Balestrino/Micro-transponder/rc4_back.jpg

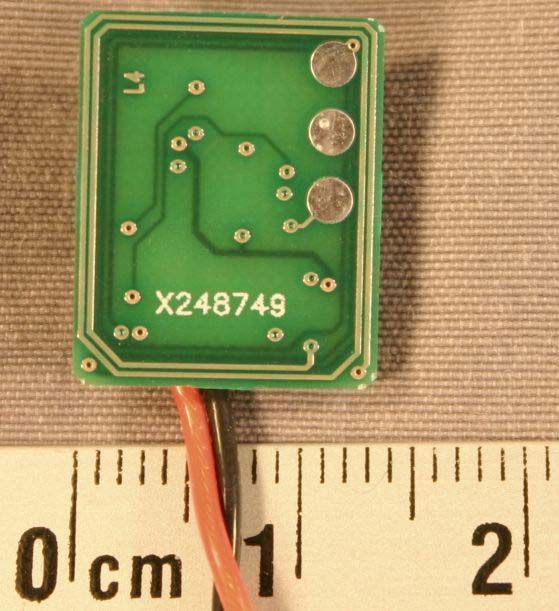
rc4_back.jpg
