Balestrino/Micro-transponder/rc4_front.jpg

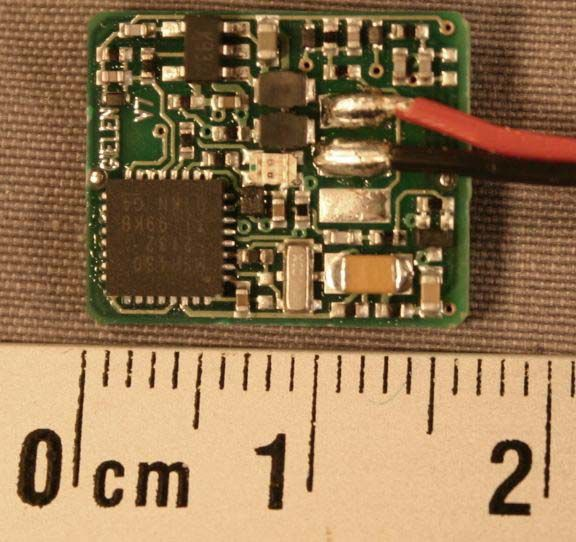
rc4_front.jpg
