Balestrino/Micro-transponder/2018_05_05/IMG_9358.JPG

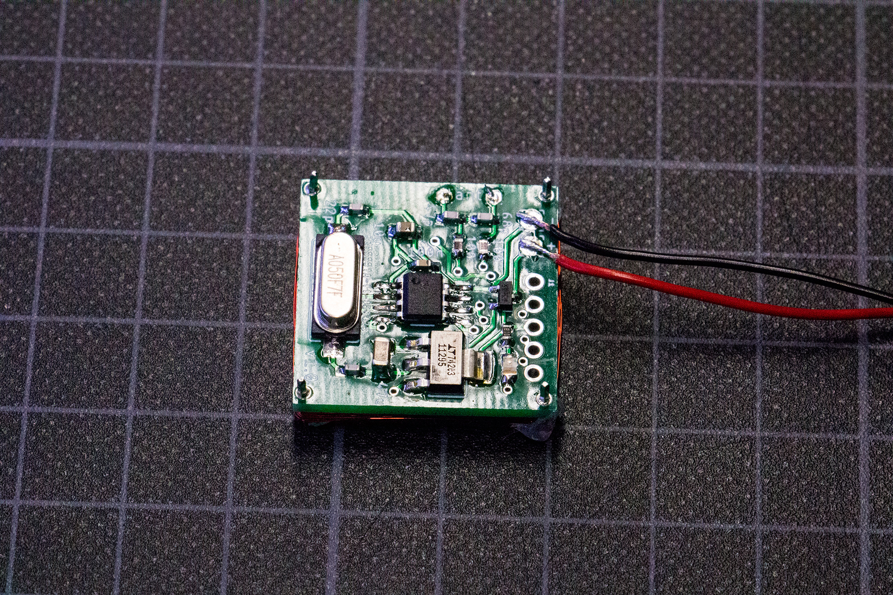
2018_05_05/IMG_9358.JPG
