Balestrino/Micro-transponder/2018_05_05/IMG_9359.JPG

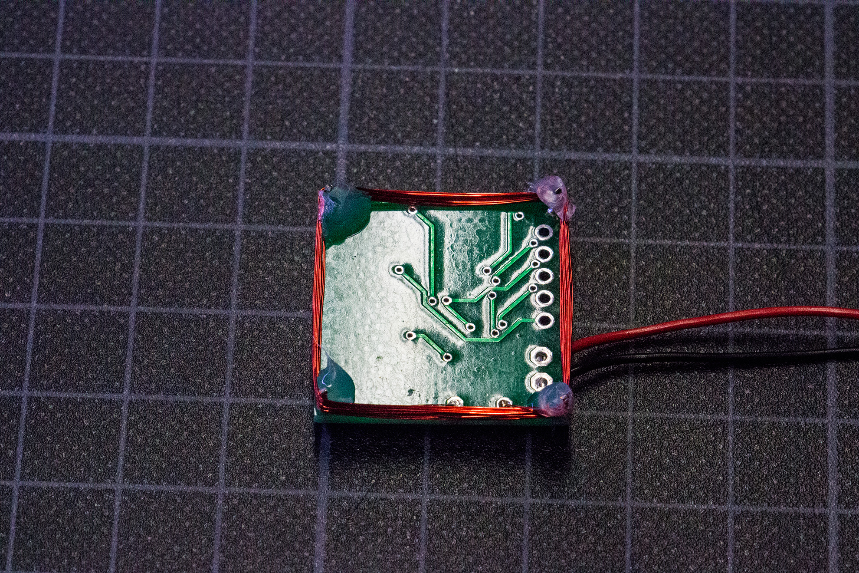
2018_05_05/IMG_9359.JPG
