Balestrino/Micro-transponder/loop antenna calculator.png

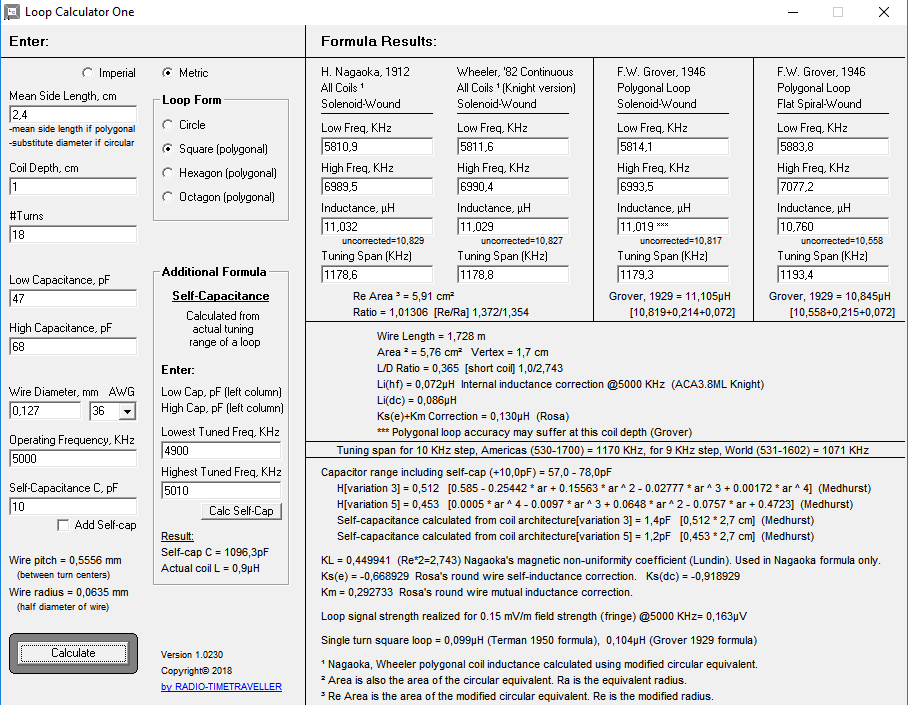
loop antenna calculator.png
