Balestrino/Micro-transponder/ssys_micro-transponder/micro-transponder.bmp

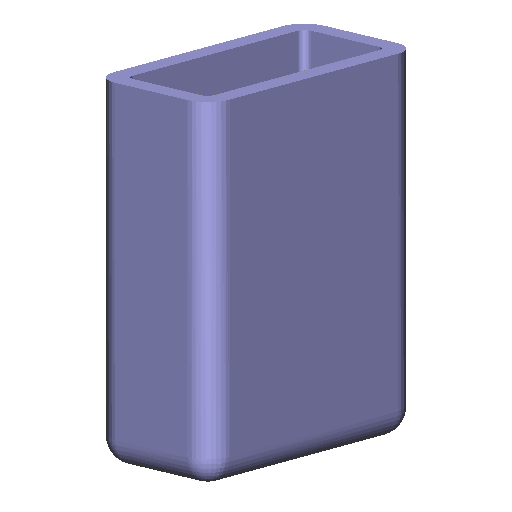
ssys_micro-transponder/micro-transponder.bmp
