Balestrino/Micro-transponder/CASE/Transpoder-case.SLDASM

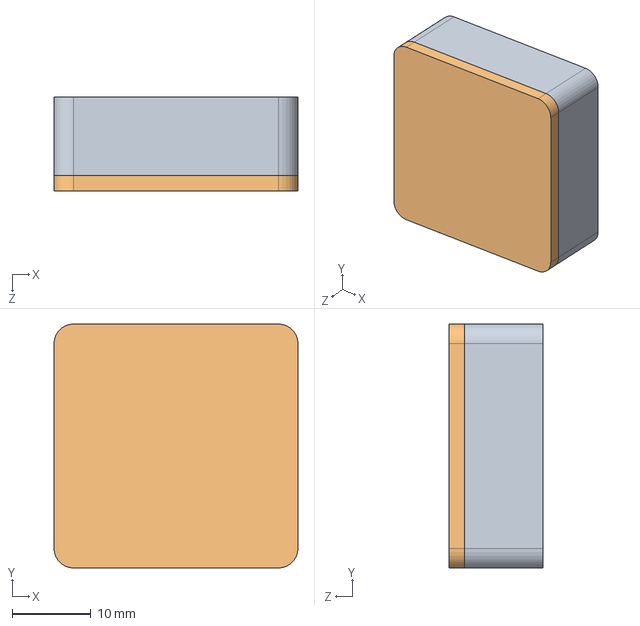
[picture p7: CAD file, 2021-03-31]
CASE/Transpoder-case.SLDASM
31.0 x 31.0 x 12.0 mm
Transponder-Case
Transponder-top
