Balestrino/Micro-transponder/CASE/Transponder-top.SLDPRT

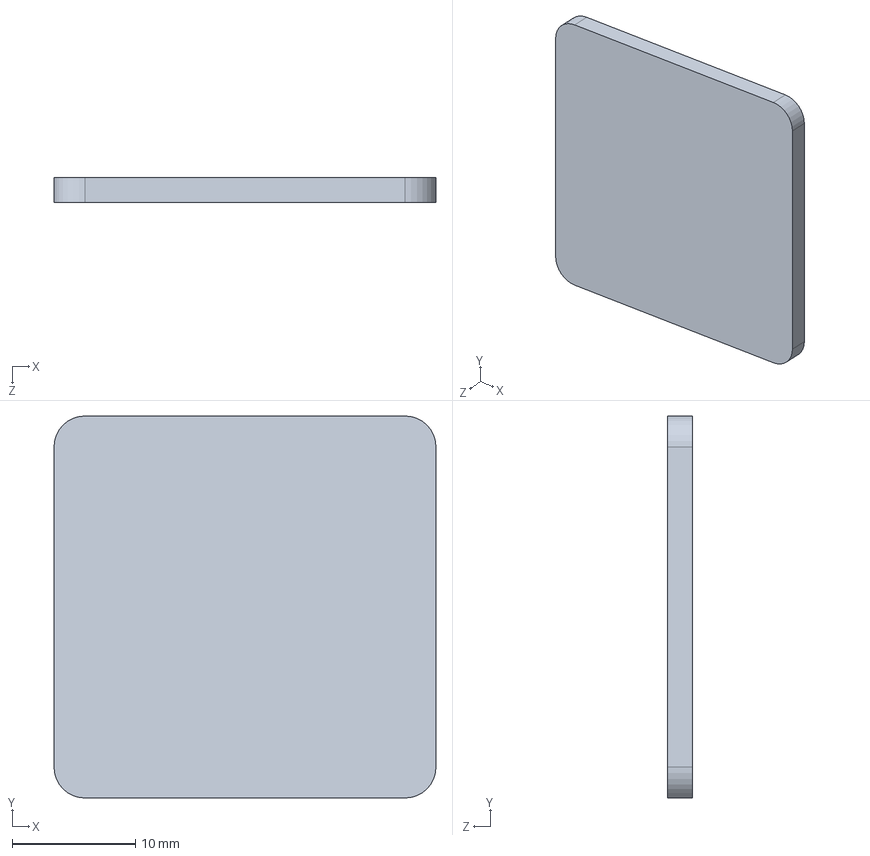
[picture p8: CAD file, 2021-03-31]
CASE/Transponder-top.SLDPRT
31.0 x 31.0 x 2.00 mm
