Balestrino/Micro-transponder/micro-transponder.SLDPRT

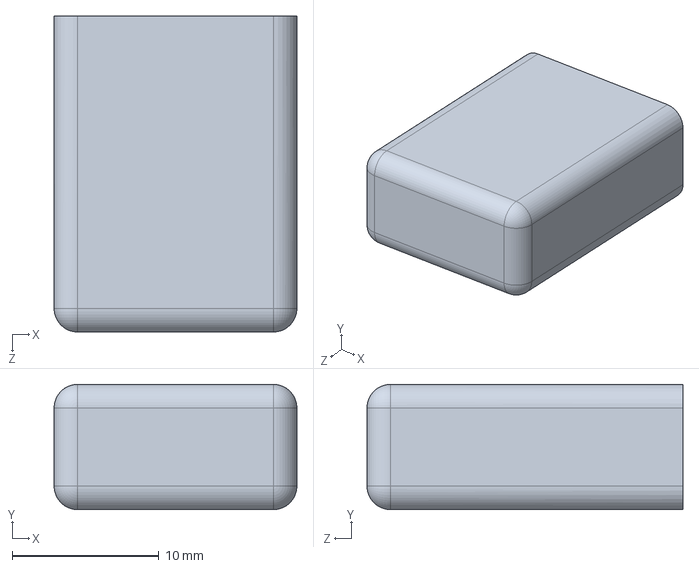
[picture p9: CAD file, 2021-03-31]
micro-transponder.SLDPRT
16.5 x 8.52 x 21.5 mm
