Balestrino/Micro-transponder/CASE/antenna_holder.SLDPRT

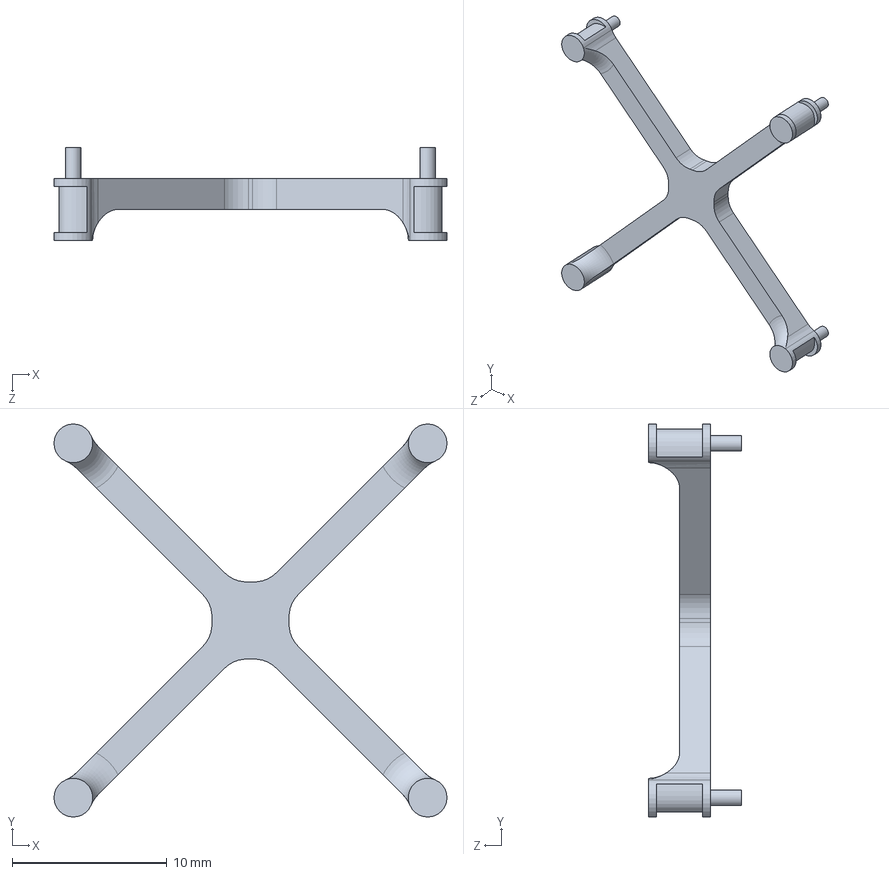
[picture p10: CAD file, 2021-03-31]
CASE/antenna_holder.SLDPRT
25.4 x 25.4 x 6.00 mm
