Balestrino/Micro-transponder/CASE/Transponder-Case.SLDPRT

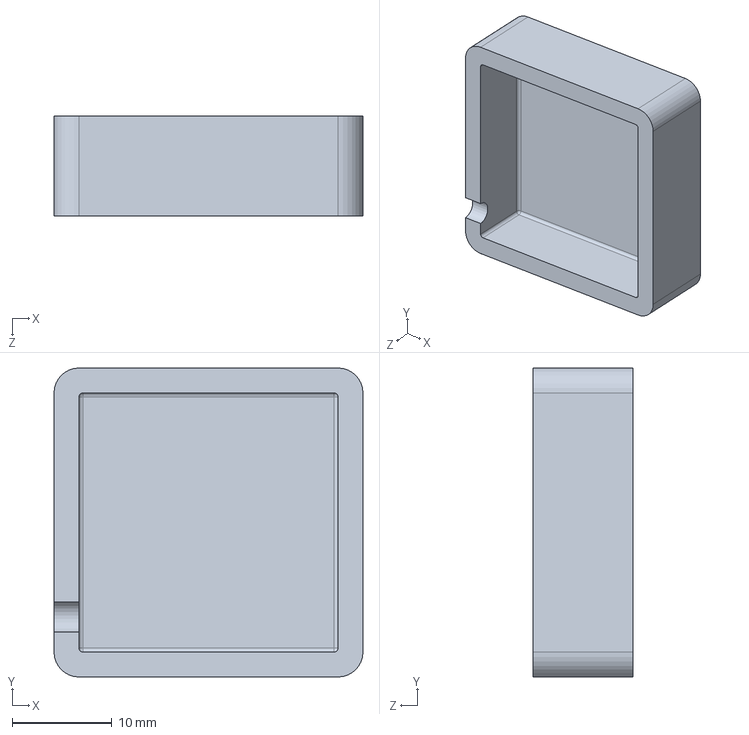
[picture p11: CAD file, 2021-03-31]
CASE/Transponder-Case.SLDPRT
31.0 x 31.0 x 10.0 mm
