Balestrino/Micro-transponder/(list of files, cad)

Other CAD files:
CASE/Transponder-Case.STL
CASE/Transponder-top.STL
CASE/antenna_holder.STL
micro-transponder.STL
