Balestrino/Micro-transponder/schematics.pdf

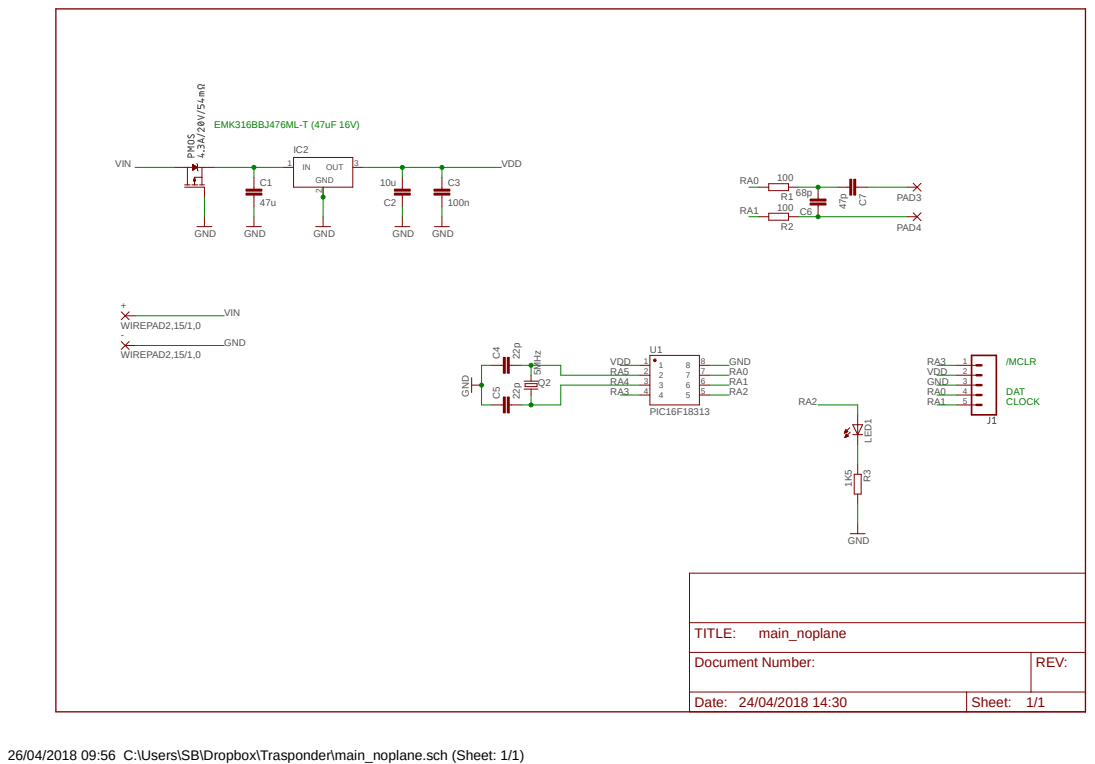
[picture p12: page 1]

Document Number: | REV:

Date: 24/04/2018 14:30 | Sheet: 1/1

26/04/2018 09:56 C:\Users\SB\Dropbox\Trasponder\main_noplane.sch (Sheet: 1/1)
