Balestrino/Micro-transponder/Electronic board/micro_transponder.brd

## EAGLE design Electronic board/micro_transponder.brd (2021-03-31)

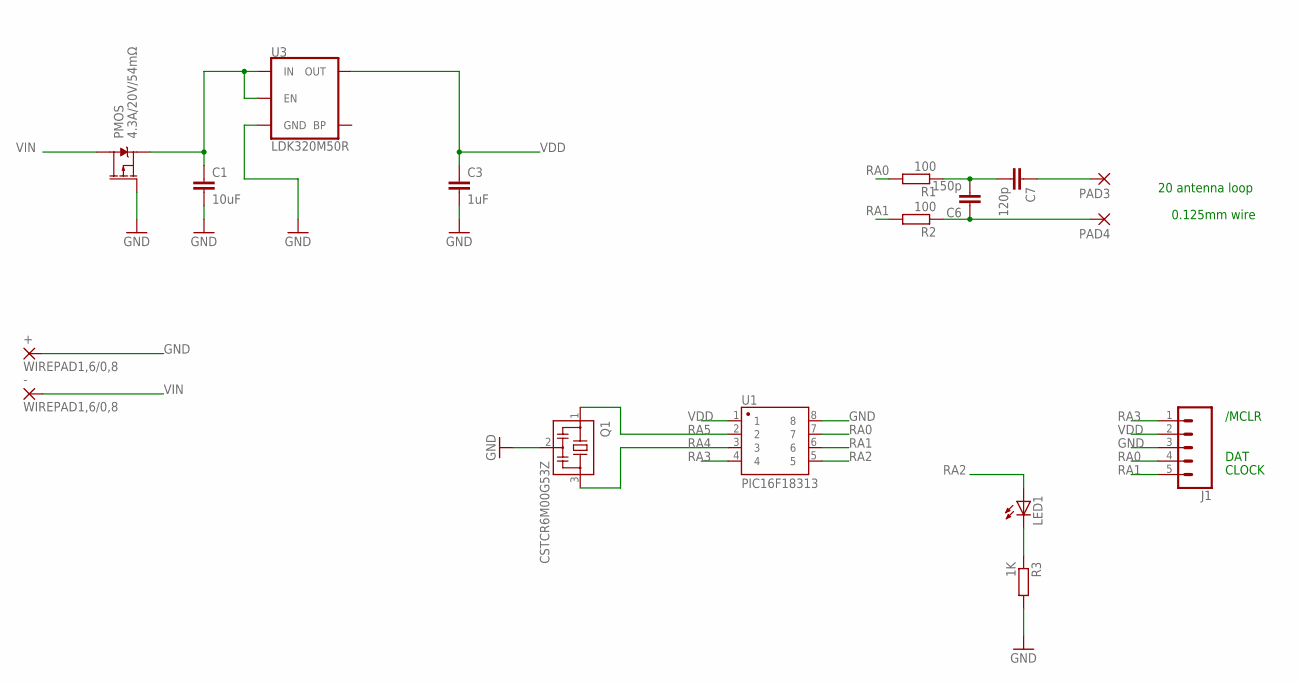
[picture p13: schematic micro_transponder.sch]

Parts:
+: WIREPAD1,6/0,8; 1,6/0,8
-: WIREPAD1,6/0,8; 1,6/0,8
C1: 10uF; C0805
C3: 1uF; C0603
C6: 150p; C0603
C7: 120p; C0603
J1: CONN_051.27MM; 1X05_1.27MM
LED1: LEDCHIP-LED0805; CHIP-LED0805
PAD3, PAD4: 1,6/0,9
PMOS: 4.3A/20V/54mΩ; SOT23-3
Q1: CSTCR6M00G53Z; CSTCR6M
R1, R2: 100; R0603
R3: 1K; R0603
U1: PIC16F18313; SOIC8
U3: LDK320M50R; SOT23-5

Connections:
GND: +.1, C1.2, C3.2, J1.3, PMOS.1 (G), Q1.2, R3.2, U1.8, U3.2 (GND)
unnamed: C1.1, PMOS.2 (S), U3.1 (IN), U3.3 (EN)
unnamed: C6.2, C7.2, R1.1
unnamed: C6.1, PAD4.1, R2.1
unnamed: LED1.C, R3.1
unnamed: C7.1, PAD3.1
RA0: J1.4, R1.2, U1.7
RA1: J1.5, R2.2, U1.6
RA2: LED1.A, U1.5
RA3: J1.1, U1.4
RA4: Q1.3, U1.3
RA5: Q1.1, U1.2
VDD: C3.1, J1.2, U1.1, U3.5 (OUT)
VIN: -.1, PMOS.3 (D)

Notes on the sheet:
/MCLR
DAT
CLOCK
20 antenna loop
0.125mm wire

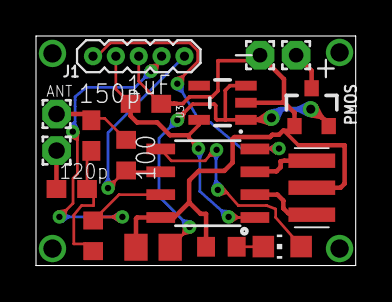
[picture p14: board micro_transponder.brd from above]

Board: 2 copper layers, 17.8 x 12.8 mm, 17 parts (0 on the bottom side), 14 nets.
