Balestrino/Micro-transponder/Electronic board/main.brd

## EAGLE design Electronic board/main.brd (2021-03-31)

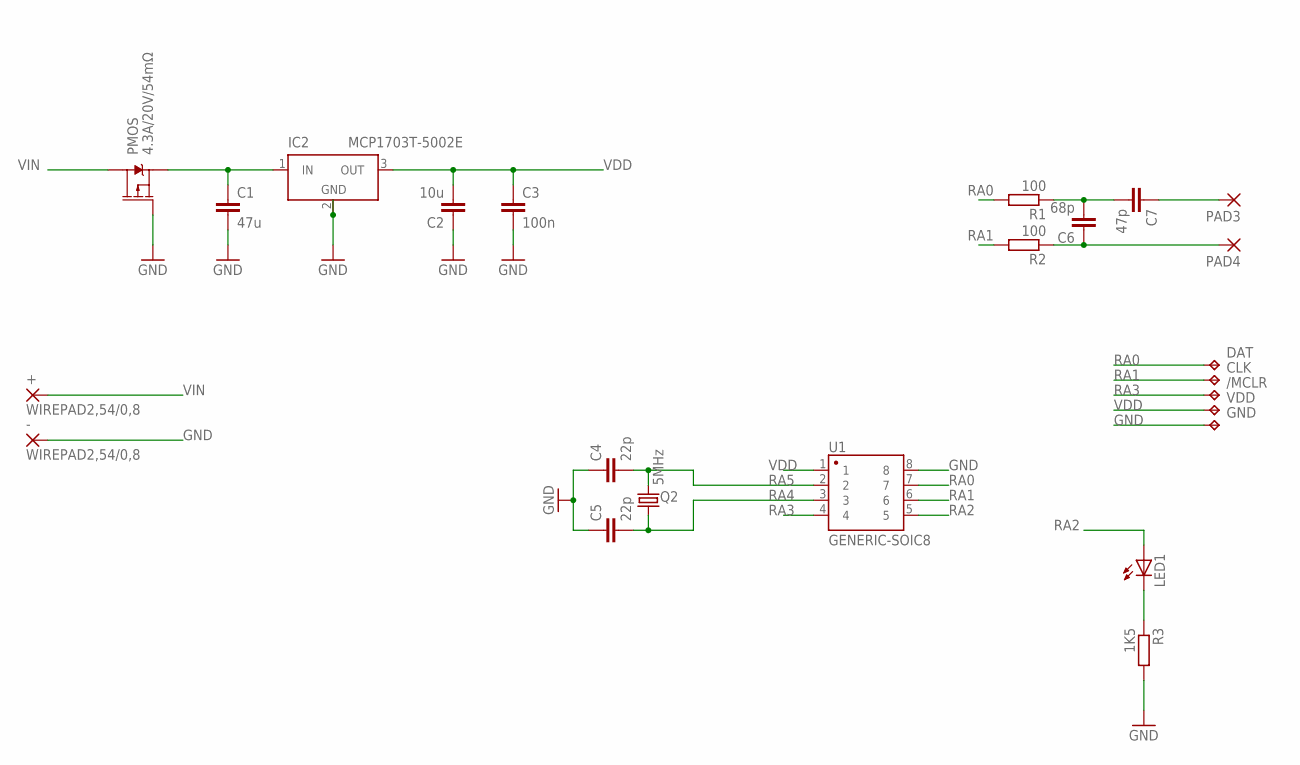
[picture p15: schematic main.sch]

Parts:
+: WIREPAD2,54/0,8; 2,54/0,8
-: WIREPAD2,54/0,8; 2,54/0,8
/MCLR: TPTP08SQ; TP08SQ
C1: 47u; C1206
C2: 10u; C1206
C3: 100n; C0603
C4, C5: 22p; C0603
C6: 68p; C0603
C7: 47p; C0603
CLK: TPTP08SQ; TP08SQ
DAT: TPTP08SQ; TP08SQ
GND: TPTP08SQ; TP08SQ
IC2: MCP1703T-5002E; SOT223
LED1: LEDCHIP-LED0603; CHIP-LED0603
PAD3, PAD4: 1,6/0,9
PMOS: 4.3A/20V/54mΩ; SOT23-3
Q2: 5MHz; HC49UP
R1, R2: 100; R0603
R3: 1K5; R0603
U1: GENERIC-SOIC8; SO08-UNIVERSAL
VDD: TPTP08SQ; TP08SQ

Connections:
GND: -.1, C1.2, C2.1, C3.2, C4.1, C5.1, GND.TP, IC2.2 (GND), IC2.4 (GND), PMOS.1 (G), R3.2, U1.8
unnamed: C1.1, IC2.1 (IN), PMOS.2 (S)
unnamed: C6.2, C7.2, R1.1
unnamed: C6.1, PAD4.1, R2.1
unnamed: LED1.C, R3.1
unnamed: C7.1, PAD3.1
RA0: DAT.TP, R1.2, U1.7
RA1: CLK.TP, R2.2, U1.6
RA2: LED1.A, U1.5
RA3: /MCLR.TP, U1.4
RA4: C5.2, Q2.1, U1.3
RA5: C4.2, Q2.2, U1.2
VDD: C2.2, C3.1, IC2.3 (OUT), U1.1, VDD.TP
VIN: +.1, PMOS.3 (D)

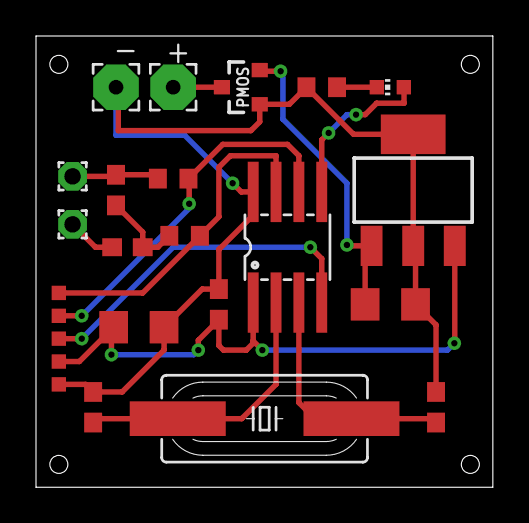
[picture p16: board main.brd from above]

Board: 2 copper layers, 25.4 x 25.1 mm, 24 parts (0 on the bottom side), 14 nets.
